muxall/IR_Detector/README.md

# IR_Detector
Muxall Active Infrared Detector repo for IRD code, schematics and gerber files.

See <a href="https://www.youtube.com/channel/UC_aUZqdsquT11l7CI8v8KFQ">Muxall Open IoT Video Blog</a> for videos covering the design and layout of the IRD.
