muxall/IR_Detector/ird_v2_schematic.pdf

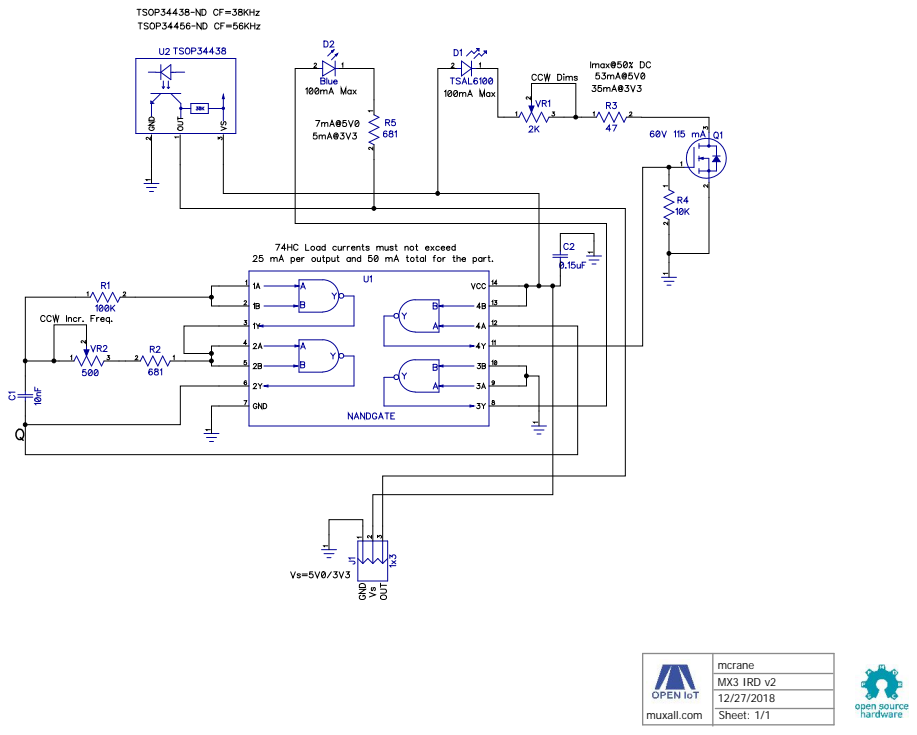
[picture p1: page 1]
mcrane MX3 IRD v2; muxall.com; Sheet: 1/1
