muxall/IR_Detector/ird_v1_schematic.pdf

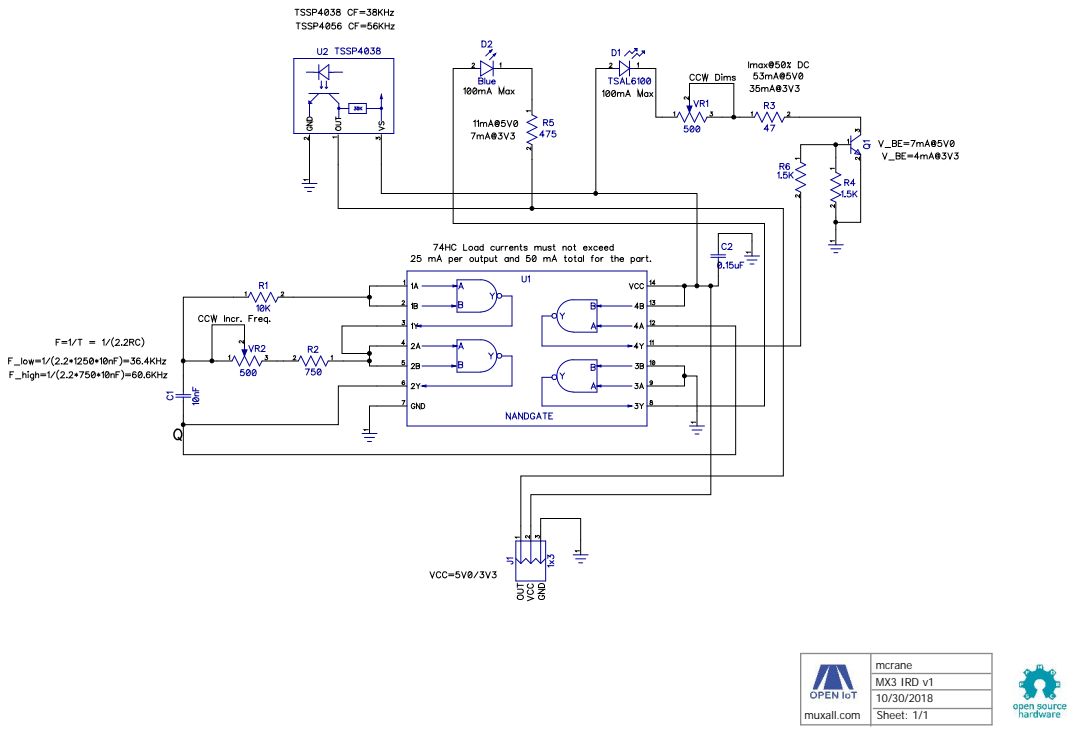
[picture p2: page 1]
mcrane MX3 IRD v1; muxall.com; Sheet: 1/1
