muxall/IR_Detector/(commit log)

2018-12-19 IRD code for Raspberry Pi
    Initial upload of IRD demo code, written in Python for Raspbian.
2018-12-19 IRD Code for Arduino
    IRD demo code for Arduino written in C.
2018-12-26 IR Detector V1 Schematic
    This is the prototype V1 schematic. It has some errors and should not be used. It has been uploaded for reference only.
2018-12-28 IRD v2 Schematic
2018-12-28 IRD v2 Gerbers
2019-01-11 Test Results IRD PCB V1 with V2 mods
